buxiaoyang/LED6432Clock/sch_pcb/LED6432Clock BOM V2.csv

ID | Name | Designator | Footprint | Quantity | Manufacturer Part | Manufacturer | Supplier | Supplier Part | LCSC Assembly
1 | ATMEGA16A-AU | U2 | TQFP-44_10X10X08P | 1 | ATMEGA16A-AU | MICROCHIP | LCSC | C5658 | Yes
2 | PCF8563T/5,518 | U1 | SOIC-8_150MIL | 1 | PCF8563T/5,518 | NXP | LCSC | C7440 | Yes
3 | ISP Header | P1 | HDR-5X2/2.54 | 1 | 2*5pHeaders Pins 2.54mm | CJT(长江连接器) | LCSC | C225297
4 | RGB CONNECTOR | P3 | HDR-8X2/2.54 | 1 | 2.54mm,2×8Double female header | BOOMELE | LCSC | C30734
5 | KEY COLOR | SW1 | KEY-TOUCH-DIP-6.0*6.0*H-(YX)_1 | 1 | KAN0611-0701B-C | GANGYUAN | LCSC | C231653
6 | KEY UP | SW2 | KEY-TOUCH-DIP-6.0*6.0*H-(YX)_1 | 1 | KAN0611-0701B-C | GANGYUAN | LCSC | C231653
7 | KEYDOWN | SW3 | KEY-TOUCH-DIP-6.0*6.0*H-(YX)_1 | 1 | KAN0611-0701B-C | GANGYUAN | LCSC | C231653
8 | KEYMODE | SW4 | KEY-TOUCH-DIP-6.0*6.0*H-(YX)_1 | 1 | KAN0611-0701B-C | GANGYUAN | LCSC | C231653
9 | GL5537-1 | R4 | RES-PHOTO_CDS | 1 | GL5537-1 | Senba | LCSC | C125628
10 | 32.768KHz | X1 | SMD-3215_2P | 1 | Q13FC1350000400 | EPSON | LCSC | C32346
11 | 5pF | C1 | 0603' | 1 | CL10C150JB8NNNC | SAMSUNG | LCSC | C1644
12 | 10K | R2,R3 | 0603' | 2 | 0603WAF1002T5E | UniOhm | LCSC | C25804
13 | 4.7K | R5,R1 | 0603' | 2 | 0603WAF4701T5E | UniOhm | LCSC | C23162
14 | 620 | R7 | 0603' | 1 | 0603WAF6200T5E | UniOhm | LCSC | C23220
15 | 204-10SUGD/S400-A4 | LED1 | LED-0603 | 1 | KT-0603R | KENTO | LCSC | C2286
16 | 1N4007 | D1,D2 | SMA/DO-214AC | 2 | M7 | MDD | LCSC | C95872
17 | CR2032-BS-6-1 | B1 | BATTERY-3 | 1 | CR2032-BS-6-1 | Q&J | LCSC | C70377
18 | 10 | R6 | 0603' | 1 | 0603WAF100JT5E | UniOhm | LCSC | C22859
19 | 10nF | C2 | 0603' | 1 | 0603B103K500NT | FH | LCSC | C57112
20 | XH-6A | P4 | XH-6A | 1 | XH-6A | BOOMELE | LCSC | C5663
21 | XH-6AW | P5 | XH-6AW | 1 | XH-6AW | BOOMELE | LCSC | C8876
22 | DS18B20 | P2 | XH-3AW | 1 | XH-3AW | BOOMELE | LCSC | C18428
23 | POWER | CN1 | XH-2AW | 1 | XH-2AW | BOOMELE | LCSC | C33132
24 | ADJUST TIME | P6 | XH-3AW | 1 | XH-3AW | BOOMELE | LCSC | C18428
