buxiaoyang/LED6432Clock/sch_pcb/LED6432Clock Schematic V2.pdf

+5V

+5V

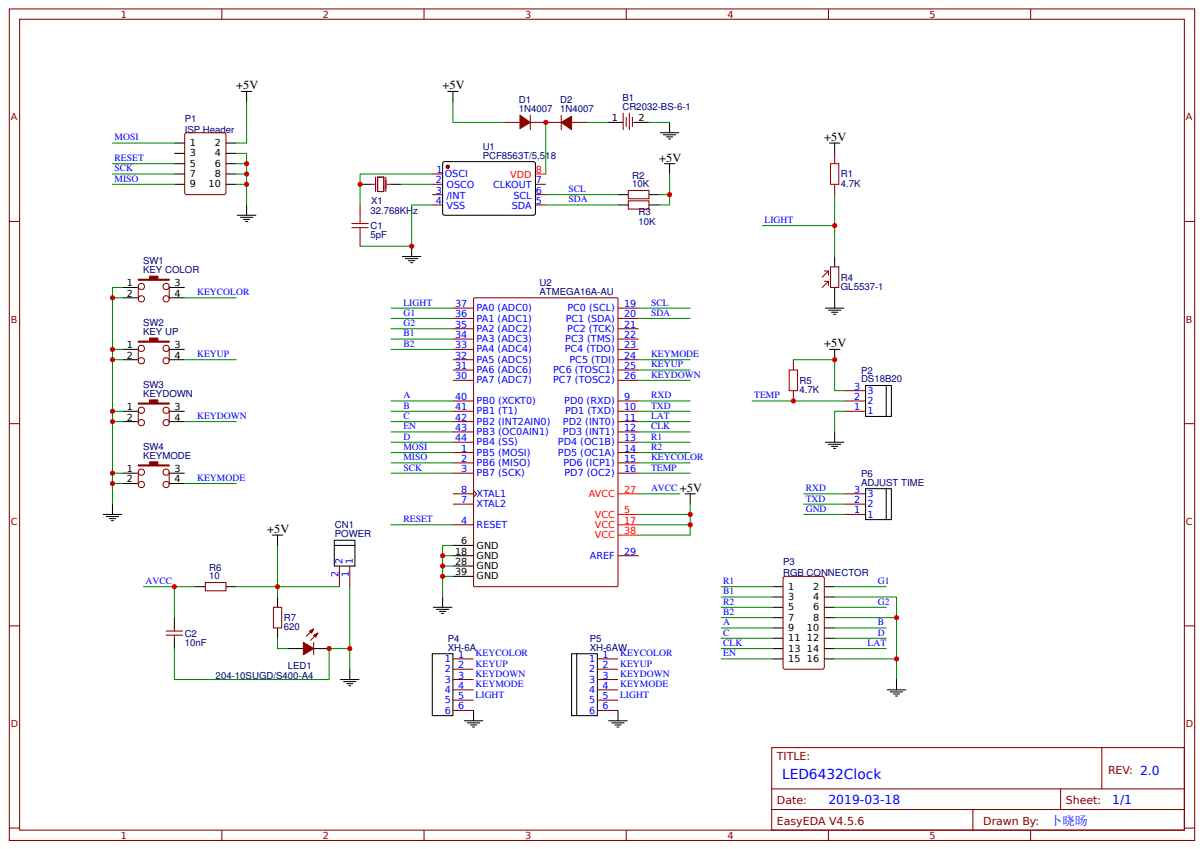
[picture p1: page 1]
