buxiaoyang/LED6432Clock/sch_pcb/LED6432Clock PCB V2.pdf

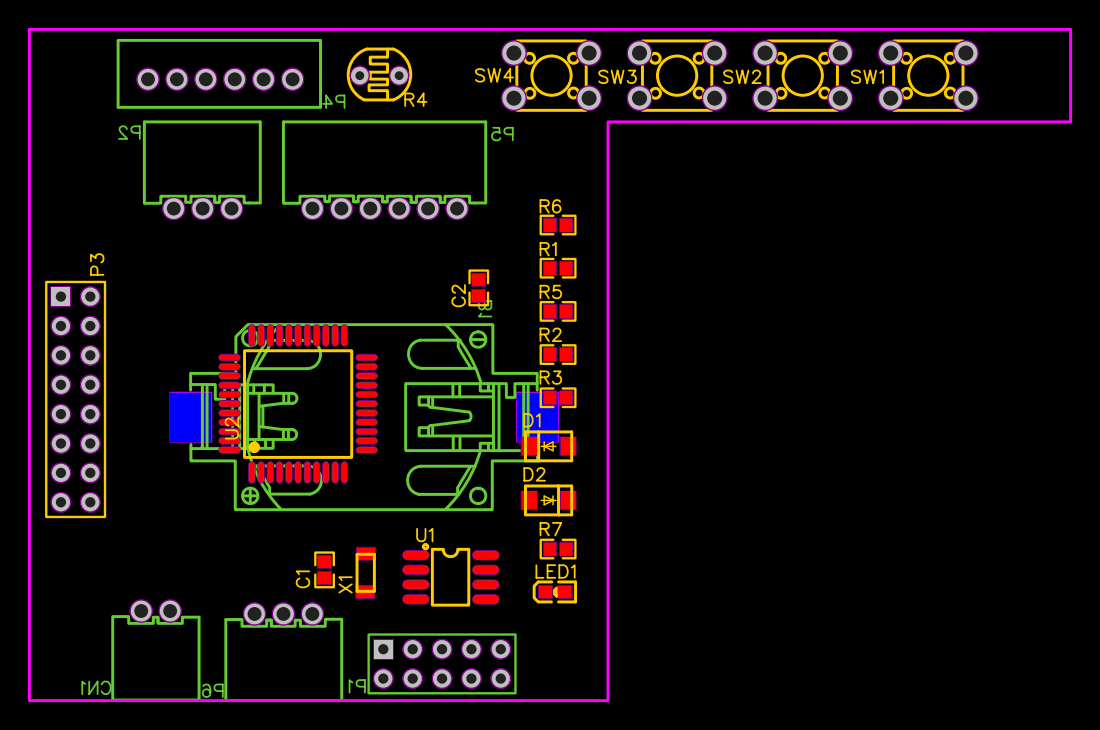
[picture p2: page 1]
