buxiaoyang/LED6432Clock/sch_pcb/LED6432Clock.pdf

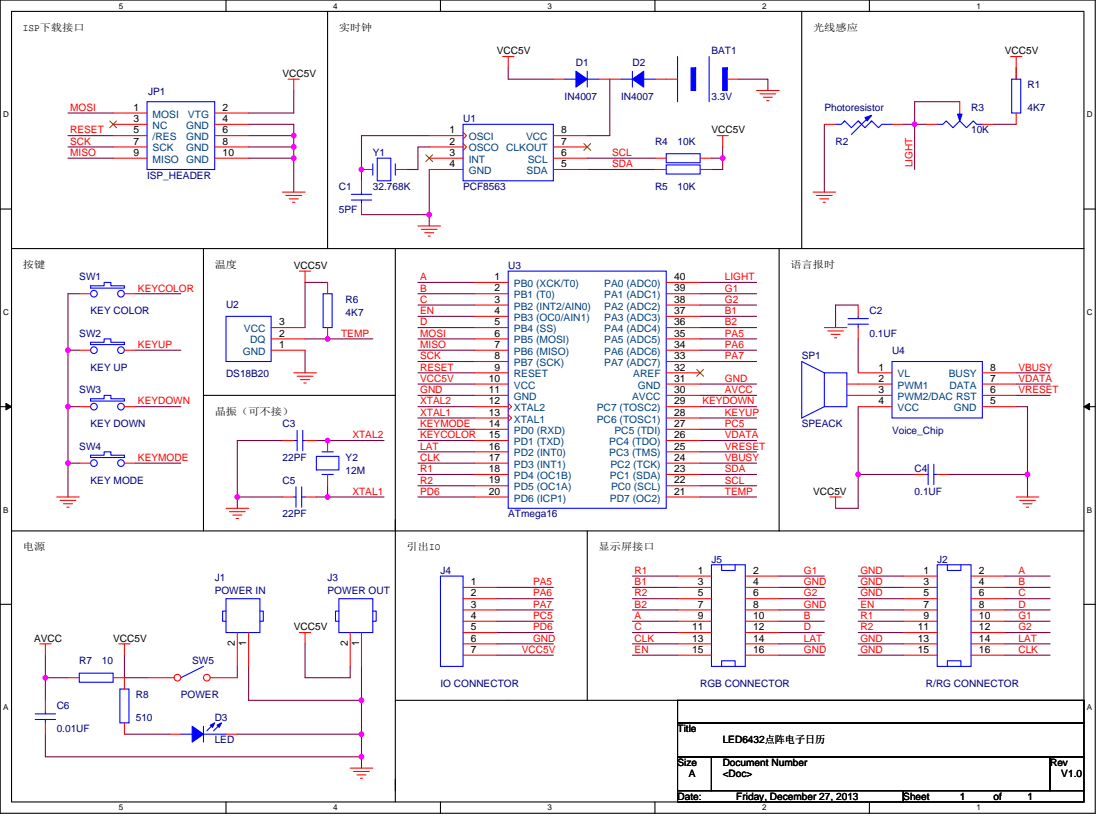
[picture p3: page 1]

Size Size Size A A A | Document Number Document Number Document Number <Doc> <Doc> <Doc> | Rev Rev Rev V1.0 V1.0 V1.0

Date: Date: Date: Friday, December 27, 2013 Friday, December 27, 2013 Friday, December 27, 2013 | Sheet Sheet Sheet 1 1 1 of of of 1 1 1
