buxiaoyang/LED6432Clock/(list of files, drawings)

Other design files:
sch_pcb/LED6432Clock.PcbDoc
