buxiaoyang/LED6432Clock/_Matrix.h

/***************************************************************************/
// 程序：LED3264电子日历
// 模块：字模
// 文件：_Matrix.h
// 作者：卜晓旸
// 版本：1.9.7
// 日期：2012年2月10日
/***************************************************************************/

#ifndef _MATRIX_H_
#define _MATRIX_H_

/*******************大数字字库靠左***********************/
const uint8 BIG_NUMBER_STYLE1[0x0A][0x2A] PROGMEM = 
{
/*--  文字: 0    --*/
/*--  宋体12;  此字体下对应的点阵为：宽x高=16x21   --*/
0x07,0x80,0x0F,0xC0,0x3F,0xE0,0x38,0x70,0x70,0x70,0x70,0x38,0x70,
0x38,0x60,0x38,0xE0,0x38,0xE0,0x38,0xE0,0x38,0xE0,0x38,0xE0,0x38,
0x60,0x38,0x70,0x38,0x70,0x30,0x70,0x70,0x3C,0xE0,0x1F,0xE0,0x0F,
0x80,0x06,0x00,

/*--  文字: 1    --*/
/*--  宋体12;  此字体下对应的点阵为：宽x高=16x21   --*/
0x03,0x00,0x1F,0x00,0xFF,0x00,0xFF,0x00,0xC7,0x00,0x07,0x00,0x07,
0x00,0x07,0x00,0x07,0x00,0x07,0x00,0x07,0x00,0x07,0x00,0x07,0x00,
0x07,0x00,0x07,0x00,0x07,0x00,0x07,0x00,0x07,0x00,0x07,0x00,0x7F,
0xF8,0x7F,0xF8,

/*--  文字: 2    --*/
/*--  宋体12;  此字体下对应的点阵为：宽x高=16x21   --*/
0x0F,0xC0,0x3F,0xF0,0x3F,0xF8,0x30,0x38,0x00,0x38,0x00,0x18,0x00,
0x18,0x00,0x38,0x00,0x38,0x00,0x38,0x00,0x70,0x00,0xE0,0x01,0xC0,
0x03,0x80,0x07,0x00,0x0E,0x00,0x1C,0x00,0x38,0x00,0x70,0x00,0x7F,
0xF8,0x7F,0xF8,

/*--  文字: 3    --*/
/*--  宋体12;  此字体下对应的点阵为：宽x高=16x21   --*/
0x1F,0x80,0x3F,0xE0,0x3F,0xF0,0x20,0x78,0x00,0x38,0x00,0x38,0x00,
0x70,0x00,0xE0,0x1F,0xC0,0x1F,0xC0,0x1F,0xF0,0x00,0x38,0x00,0x38,
0x00,0x38,0x00,0x38,0x00,0x38,0x00,0x38,0x60,0xF0,0x7F,0xF0,0x7F,
0xC0,0x0E,0x00, 

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
	0x08,0x84,0x08,0x84,0x10,0x84,0x11,0x04,
	0x21,0x04,0x42,0x04,0x04,0x28,0x08,0x10,
	
	/*--  46 扰  --*/ 
	0x10,0x40,0x10,0x50,0x10,0x48,0x10,0x40,
	0xFC,0x44,0x13,0xFE,0x14,0x40,0x18,0x60,
	0x30,0xA0,0xD0,0xA0,0x10,0xA0,0x10,0xA0,
	0x11,0x22,0x11,0x22,0x52,0x1E,0x24,0x00,
	
	/*--  47 关  --*/ 
	0x10,0x10,0x08,0x18,0x04,0x20,0x04,0x48,
	0x7F,0xFC,0x01,0x00,0x01,0x00,0x01,0x04,
	0xFF,0xFE,0x01,0x00,0x02,0x80,0x02,0x80,
	0x04,0x40,0x08,0x30,0x30,0x0E,0xC0,0x04,
	
	/*--  48 闭  --*/ 
	0x20,0x04,0x1B,0xFE,0x08,0x04,0x40,0x84,
	0x40,0xA4,0x5F,0xF4,0x40,0x84,0x41,0x84,
	0x42,0x84,0x44,0x84,0x48,0x84,0x50,0x84,
	0x40,0x84,0x42,0x84,0x41,0x14,0x40,0x08
};

#endif
