buxiaoyang/LED6432Clock/_Timers.h

/***************************************************************************/
// 程序：LED3264电子日历
// 模块：定时器
// 文件：_Timers.h
// 作者：卜晓旸
// 版本：1.9.7
// 日期：2012年2月10日
/***************************************************************************/

#ifndef _TIMERS_H_
#define _TIMERS_H_



void timer0_init(void)
{
	TCCR0=0x00;//停止
	TCNT0=0x00;//清除定时器值
	TCCR0=0x79;//快速PWM模式,匹配时OC0清零,top时置数,系统时钟1024分频,输出比较匹配清除定时器值
	if(RunParameter[18] <= 8)
	{
		SET_DISPLAY_LIGHT;//OCR0置初值,占空比50%，调整OCR0的值用来调整占空比
	}
	else
	{
		OCR0 = 0x64;
	}
}

void timer2_init(void)
{
	TCCR2  = 0x00;//停止定时器
	ASSR   = 0x00;//异步时钟模式
	TCNT2  = 0x83;//初始值
	OCR2   = 0x82;//匹配值
	TIMSK |= 0x40;//中断允许
	TCCR2  = 0x04;//启动定时器
}

/*定时器2的中断服务程序，用于显示处理*/
SIGNAL(SIG_OVERFLOW2)
{
	//1ms
	PLUSE_Out();
	SPEEK_Time();
	if( Mode == 0 && SPEEK_TIME_Status == 0)
	{
		ReadDS18B20Count ++;
		if(ReadDS18B20Count == 51250)
		{
			ds1820_start();    
		}
		
		if(ReadDS18B20Count > 60000)
		{
			ReadTemputer(); 
			ReadDS18B20Count = 0;
		}	
		if(!display_light_Mode)
		{
			AD_time_count ++;
			if(AD_time_count == 12000)
			{
				StartAD();    
			}
		
			if(AD_time_count > 12300)
			{
				GetDispalyLight(); 
				AD_time_count = 0;
			}	
		}
	}
	KEY_Time_count ++;	
	KEY_Time_count_speed_color ++;
	TCNT2 = 0x83;
}

#endif
