buxiaoyang/LED6432Clock/(commit log)

2014-02-23 V1.7.3_温度时间显示完成
2014-02-23 V1.7.6_除调光校时红外其他都OK了
2014-02-23 V1.9.7_自动亮度修正_电路图更新
2014-02-23 V2.0.7_完善字体（旧电路图最终版本）
2014-02-23 V2.1.0_设置字体更新大字体
2014-02-23 V2.1.3_语音报时OK
2014-02-23 V2.1.4_加入全彩屏
2014-02-23 V2.1.8_全彩温度OK
2014-02-23 V2.1.9_秒显示OK
2014-02-23 V2.2.0_加入三色显示
2016-02-23 Add PCB init.
    [LED6432Clock.PcbDoc]
2016-02-24 PCB Layout ready.
    [LED6432Clock.PcbDoc]
2016-02-24 PCB Layout checked.
    [LED6432Clock.PcbDoc]
2016-03-03 修改目录结构，未下载验证
    [LED6432Clock.PcbDoc]
2019-03-18 添加V2版本PCB和电路图，在线原理图PCB地址https://lceda.cn/buxiaoyang/led6432clock
    [LED6432Clock BOM V2.csv, LED6432Clock PickAndPlace V2.csv]
